hpvdt/falcon_wing_module/media/wing_control_neutral_position.png

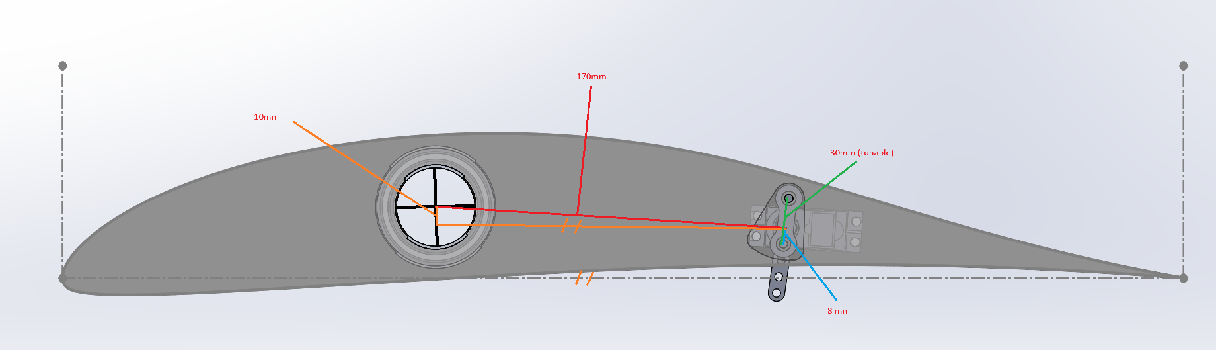
media/wing_control_neutral_position.png
