hpvdt/falcon_wing_module/media/wing_control_fully_actuated_position.png

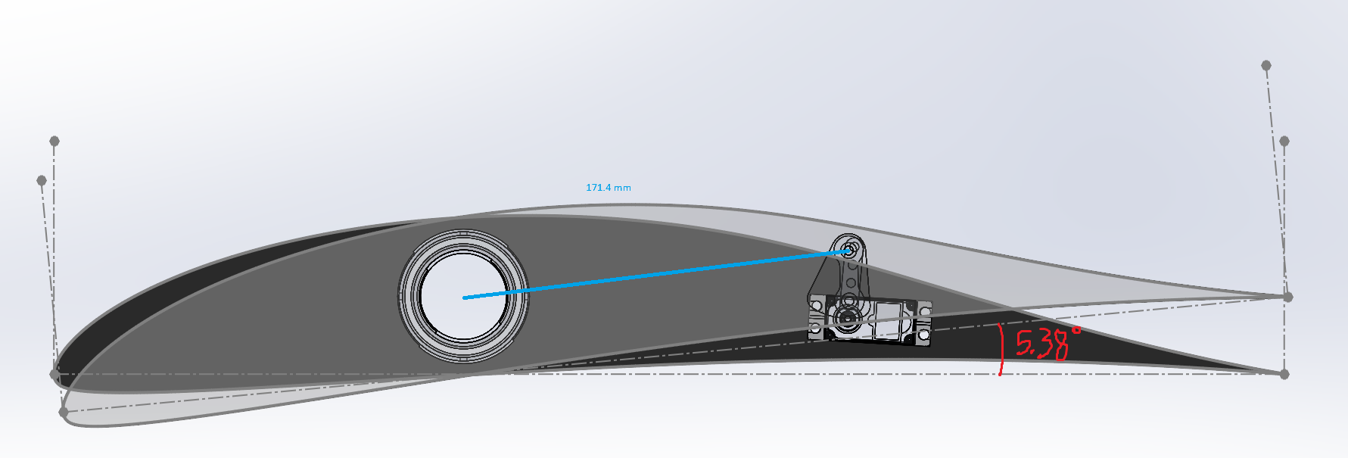
media/wing_control_fully_actuated_position.png
