hpvdt/falcon_wing_module/README.md

# falcon_wing_module
General purpose modules for handling wing duties
