hpvdt/falcon_wing_module/hardware/indicator_rev_2/TCA6408ARSVR/TCA6408ARSVR.step

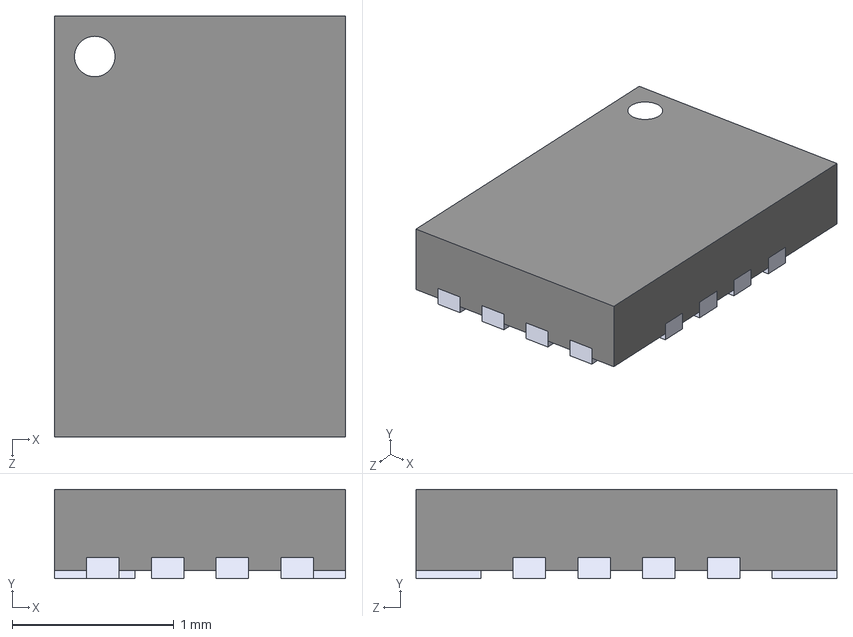
[picture p3: CAD file, 2025-09-16]
hardware/indicator_rev_2/TCA6408ARSVR/TCA6408ARSVR.step
1.80 x 0.55 x 2.60 mm
