hpvdt/falcon_wing_module/hardware/indicator_rev_2/TLV70033DCKR/TLV70033DCKR.step

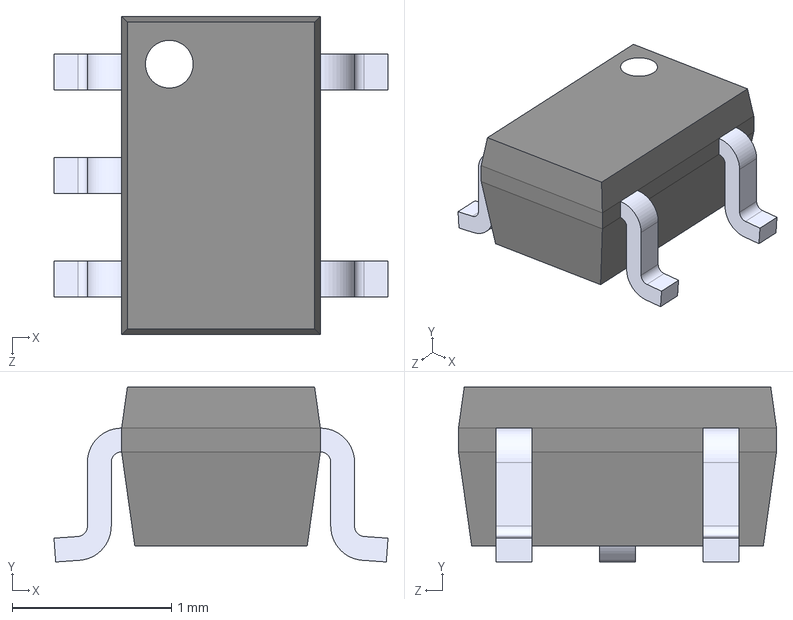
[picture p4: CAD file, 2025-09-16]
hardware/indicator_rev_2/TLV70033DCKR/TLV70033DCKR.step
2.10 x 1.10 x 2.00 mm
