hpvdt/falcon_wing_module/(threads)

Thread 2 (2025-09-02):

Add LIDAR functionality

savob, 2025-09-02:
Add functionality for the I2C LIDAR to be read and reported by these modules. We've been using [TFMini-S](https://www.sparkfun.com/tfmini-s-micro-lidar-module.html) modules, although we can change this for another option over i2C.

One thing I noticed is that UART is available over the I2C pins, although it's the same UART used for debugging so we will lose that feature if this path is taken.

Thread 3 (2025-09-02):

Add indicator board functionality

savob, 2025-09-02:
Add the needed code to operate the indicator board for the pilots. Should be a driver for the selected GPIO expander and the logic to gather and process the needed CAN frames for alerts.

Thread 4 (2025-09-03):

Control mechanism model

savob, 2025-09-03:
Nodes which are tasked with actuating control surfaces should potentially have models to describe the output angle relative to the servo angle to more accurately drive the surfaces in a way to provide the pilots a linear system.

Preliminary work has been done using the `wing_sweep.m` script to plot the system and this could be easily adapted to provide a lookup table or port the calculations directly into the modules if the math proves fast enough to run on the microcontrollers.

savob, 2025-09-03:
Some interesting approximations and calculations to consider if the math proves to be slow https://www.olliw.eu/2014/fast-functions/

Thread 5 (2025-09-06):

Issue running servo PWM and I2C

savob, 2025-09-06:
Given some unforeseen issues arising from the alternate pin function system in STM32s, the servo PWM pin (PB5) on the rev 1.0 module board cannot be properly driven when I2C is active.

The issue appears that although the SMBA pin functionality for the I2C peripheral overrides the PWM functionality on that pin, even though SMBA is not meant to be activated/used in our system. This is an issue with the design of the chip so we'll need to use modules for only one or the other function at a time.

A viable solution is to swap the pins purpose with ADD2, since the same timer has a PWM output there that is works alongside I2C, but this will need a hardware revision that is unlikely and unnecessary in the near future. We can just co-locate two modes as needed.
