hpvdt/falcon_wing_module/hardware/indicator_rev_2/indicator_rev_2.kicad_pcb

## KiCad design hardware/indicator_rev_2/indicator_rev_2.kicad_pcb (2025-09-16)

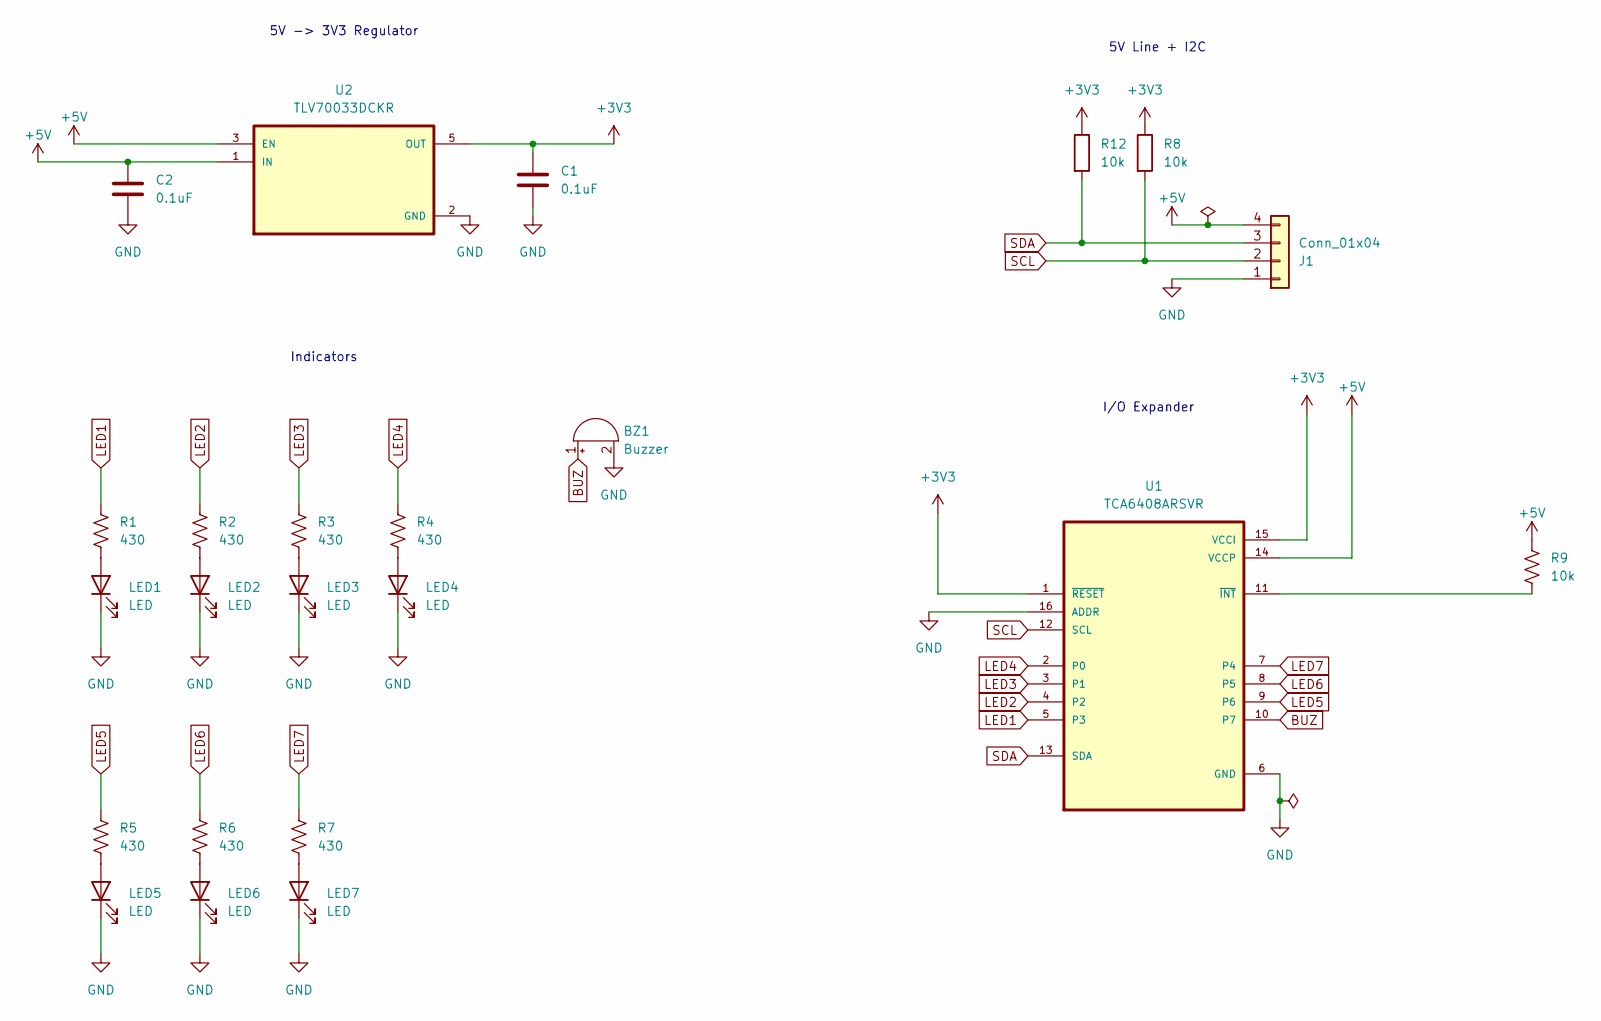
[picture p5: schematic indicator_rev_2.kicad_sch, Indicator Board]

Parts:
BZ1: Buzzer; Buzzer_12x9.5RM7.6
C1, C2: 0.1uF; C_0603_1608Metric
J1: Conn_01x04; JST_XH_S4B-XH-A_1x04_P2.50mm_Horizontal
LED1, LED2, LED3, LED4, LED5, LED6, LED7: LED; LED_D4.0mm
R1, R2, R3, R4, R5, R6, R7: 430; R_0603_1608Metric
R8, R9, R12: 10k; R_0603_1608Metric
U1: TCA6408ARSVR; QFN40P180X260X55-16N
U2: TLV70033DCKR; SOT65P210X110-5N

Connections:
+3V3: C1.1, R8.1, R12.1, U1.1 (~RESET), U1.15 (VCCI), U2.5 (OUT)
+5V: C2.1, J1.4, R9.2, U1.14 (VCCP), U2.1 (IN), U2.3 (EN)
BUZ: BZ1.1 (-), U1.10 (P7)
GND: BZ1.2 (+), C1.2, C2.2, J1.1, LED1.1 (K), LED2.1 (K), LED3.1 (K), LED4.1 (K), LED5.1 (K), LED6.1 (K), LED7.1 (K), U1.6 (GND), U1.16 (ADDR), U2.2 (GND)
LED1: R1.2, U1.5 (P3)
LED2: R2.2, U1.4 (P2)
LED3: R3.2, U1.3 (P1)
LED4: R4.2, U1.2 (P0)
LED5: R5.2, U1.9 (P6)
LED6: R6.2, U1.8 (P5)
LED7: R7.2, U1.7 (P4)
unnamed: LED1.2 (A), R1.1
unnamed: LED2.2 (A), R2.1
unnamed: LED3.2 (A), R3.1
unnamed: LED4.2 (A), R4.1
unnamed: LED5.2 (A), R5.1
unnamed: LED6.2 (A), R6.1
unnamed: LED7.2 (A), R7.1
unnamed: R9.1, U1.11 (~INT)
SCL: J1.2, R8.2, U1.12 (SCL)
SDA: J1.3, R12.2, U1.13 (SDA)

Notes on the sheet:
5V Line + I2C
I/O Expander
5V -> 3V3 Regulator
Indicators

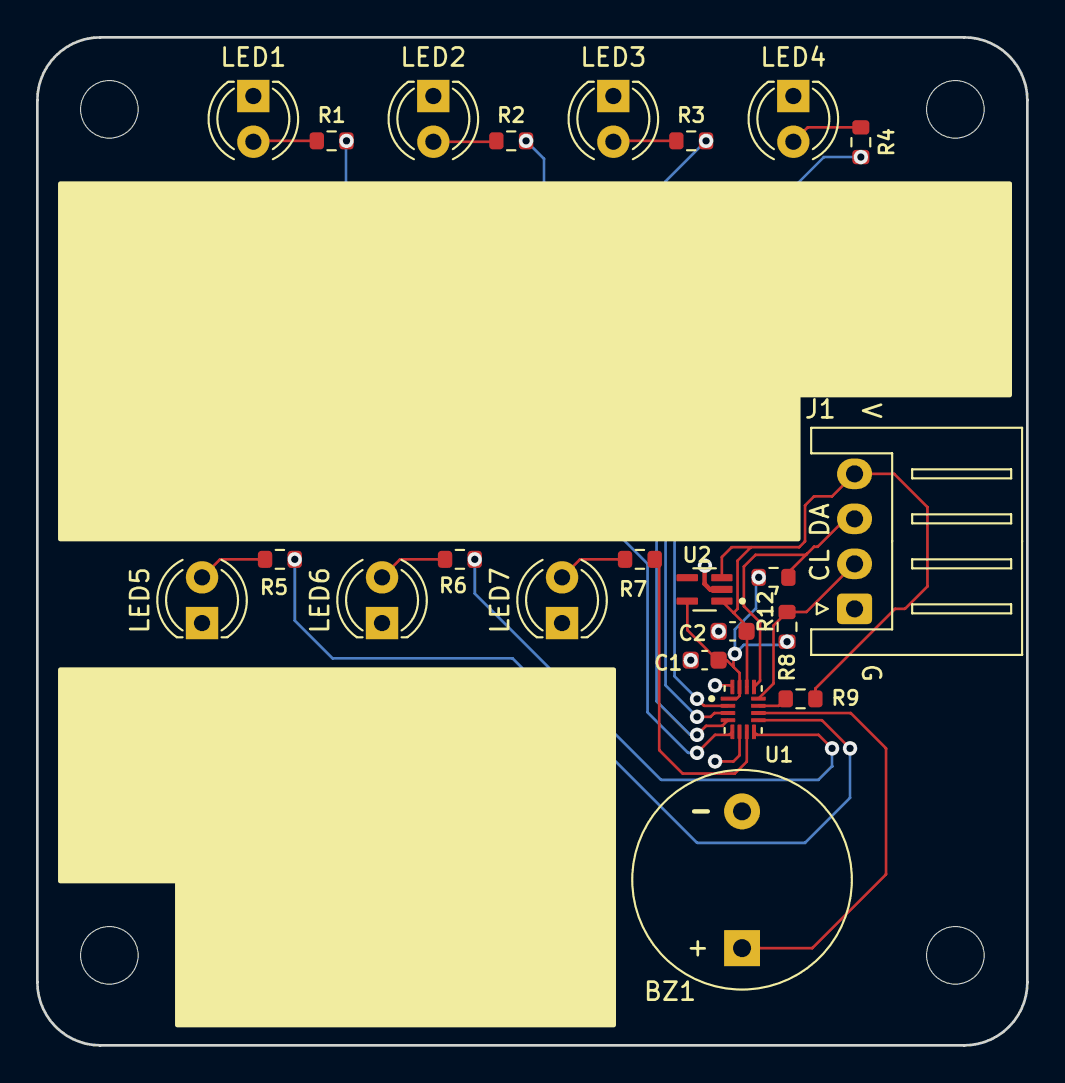
[picture p6: board indicator_rev_2.kicad_pcb from above]

Board: 2 copper layers, 55.0 x 56.0 mm, 23 parts (0 on the bottom side), 21 nets.
