hpvdt/falcon_wing_module/hardware/wing_module_rev_1/wing_module_rev_1.kicad_pcb

## KiCad design hardware/wing_module_rev_1/wing_module_rev_1.kicad_pcb (2025-08-17)

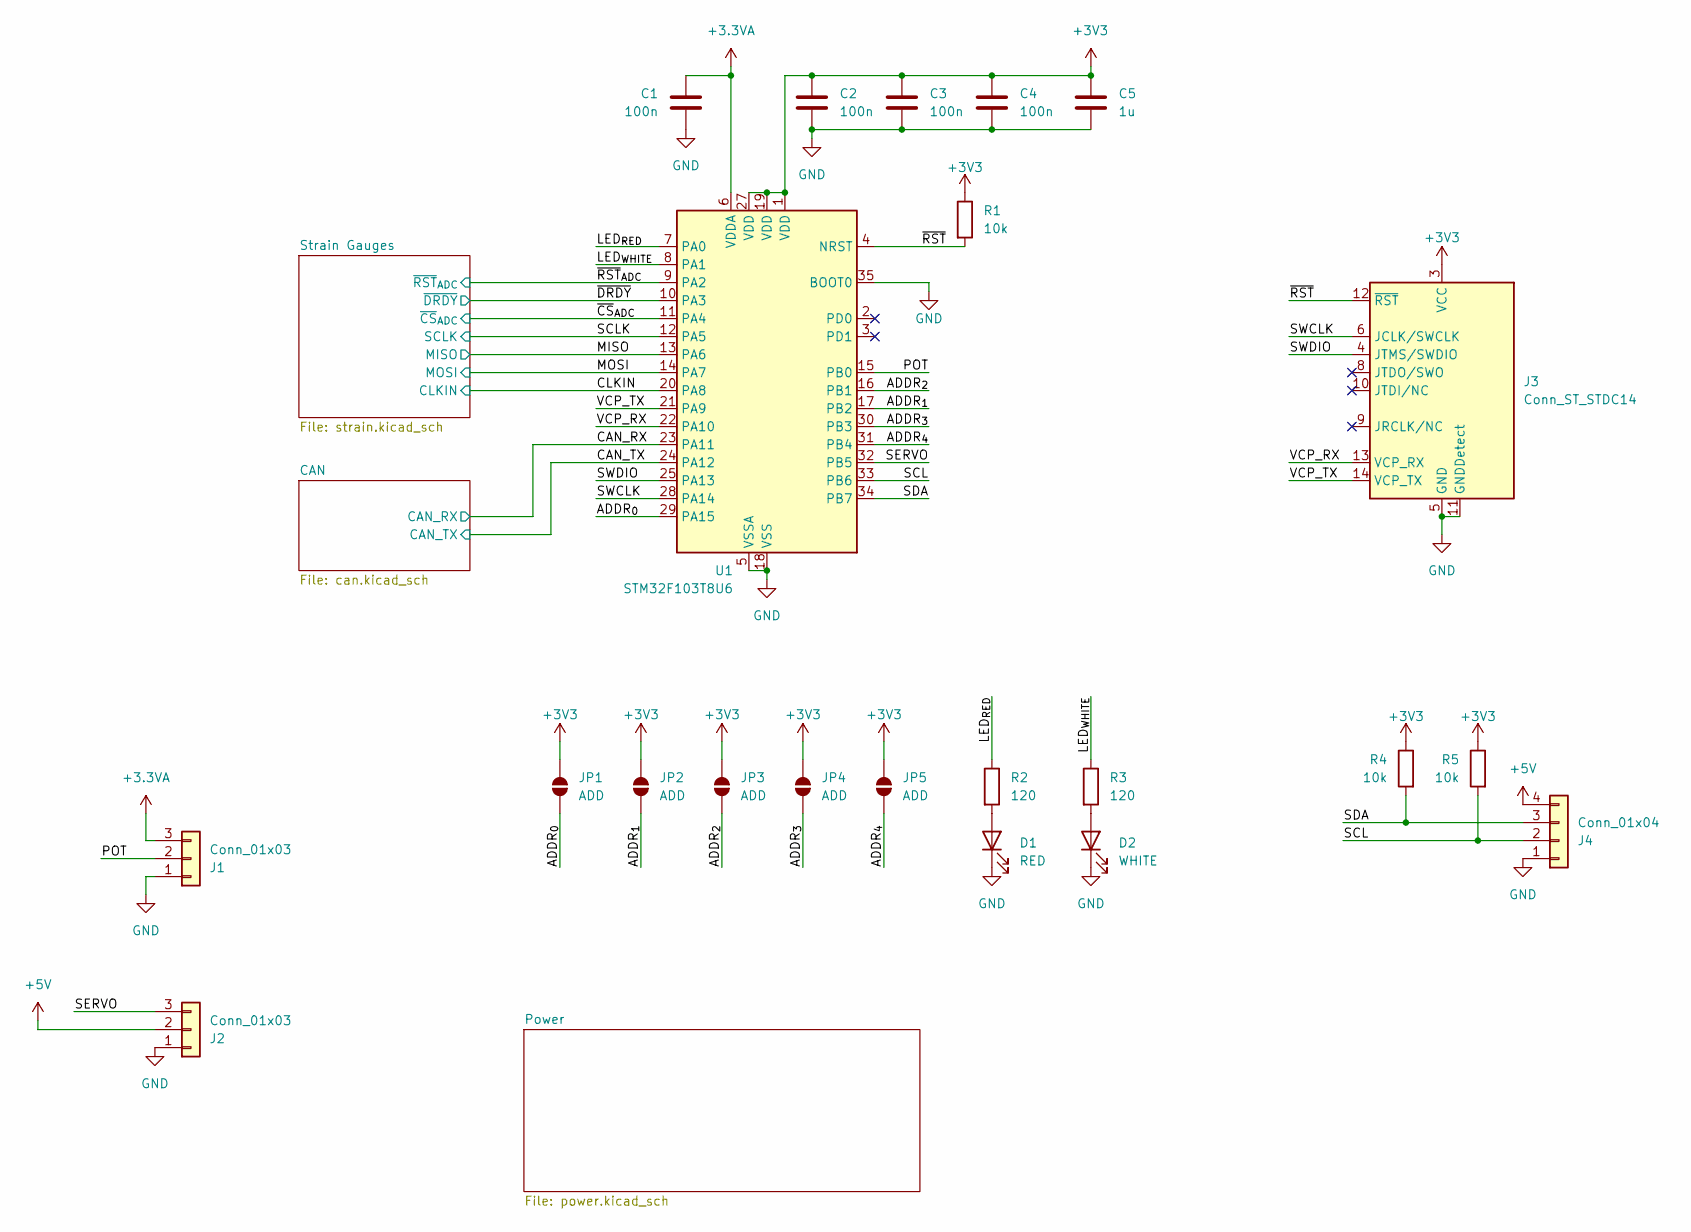
[picture p7: schematic wing_module_rev_1.kicad_sch, Wing Module]

Parts:
C1, C2, C3, C4: 100n; C_0402_1005Metric; LCSC C5448875
C5: 1u; C_0402_1005Metric; LCSC C52923
D1: RED; LED_0805_2012Metric; LCSC C84256
D2: WHITE; LED_0805_2012Metric; LCSC C34499
J1, J2: Conn_01x03; JST_EH_B3B-EH-A_1x03_P2.50mm_Vertical; LCSC C398546
J3: Conn_ST_STDC14; PinHeader_2x07_P1.27mm_Vertical_SMD; LCSC C6332251
J4: Conn_01x04; JST_EH_B4B-EH-A_1x04_P2.50mm_Vertical; LCSC C160258
JP1, JP2, JP3, JP4, JP5: ADD; SolderJumper-2_P1.3mm_Open_TrianglePad1.0x1.5mm; LCSC N/A
R1, R4, R5: 10k; R_0402_1005Metric; LCSC C723353
R2, R3: 120; R_0402_1005Metric; LCSC C25079
U1: STM32F103T8U6; QFN-36-1EP_6x6mm_P0.5mm_EP3.7x3.7mm; LCSC C19671

Connections:
+3.3VA: C1.1, J1.3, U1.6 (VDDA); also elsewhere on the board
+3V3: C2.1, C3.1, C4.1, C5.1, J3.3 (VCC), JP1.2 (B), JP2.2 (B), JP3.2 (B), JP4.2 (B), JP5.2 (B), R1.1, R4.1, R5.1, U1.1 (VDD), U1.19 (VDD), U1.27 (VDD); also elsewhere on the board
+5V: J2.2, J4.4; also elsewhere on the board
/ADDR_{0}: JP1.1 (A), U1.29 (PA15)
/ADDR_{1}: JP2.1 (A), U1.17 (PB2)
/ADDR_{2}: JP3.1 (A), U1.16 (PB1)
/ADDR_{3}: JP4.1 (A), U1.30 (PB3)
/ADDR_{4}: JP5.1 (A), U1.31 (PB4)
/CAN_RX: U1.23 (PA11); also elsewhere on the board
/CAN_TX: U1.24 (PA12); also elsewhere on the board
/CLKIN: U1.20 (PA8); also elsewhere on the board
/LED_{RED}: R2.1, U1.7 (PA0)
/LED_{WHITE}: R3.1, U1.8 (PA1)
/MISO: U1.13 (PA6); also elsewhere on the board
/MOSI: U1.14 (PA7); also elsewhere on the board
/POT: J1.2, U1.15 (PB0)
/SCL: J4.2, R5.2, U1.33 (PB6)
/SCLK: U1.12 (PA5); also elsewhere on the board
/SDA: J4.3, R4.2, U1.34 (PB7)
/SERVO: J2.3, U1.32 (PB5)
/SWCLK: J3.6 (JCLK/SWCLK), U1.28 (PA14)
/SWDIO: J3.4 (JTMS/SWDIO), U1.25 (PA13)
/VCP_RX: J3.13 (VCP_RX), U1.22 (PA10)
/VCP_TX: J3.14 (VCP_TX), U1.21 (PA9)
/~CS_{ADC}: U1.11 (PA4); also elsewhere on the board
/~DRDY: U1.10 (PA3); also elsewhere on the board
/~RST: J3.12 (~RST), R1.2, U1.4 (NRST)
/~RST_{ADC}: U1.9 (PA2); also elsewhere on the board
GND: C1.2, C2.2, C3.2, C4.2, C5.2, D1.1 (K), D2.1 (K), J1.1, J2.1, J3.5 (GND), J3.7 (GND), J3.11 (GNDDetect), J4.1, U1.5 (VSSA), U1.18 (VSS), U1.26 (VSS), U1.35 (BOOT0), U1.36 (VSS), U1.37 (VSS); also elsewhere on the board
unnamed: D1.2 (A), R2.2
unnamed: D2.2 (A), R3.2

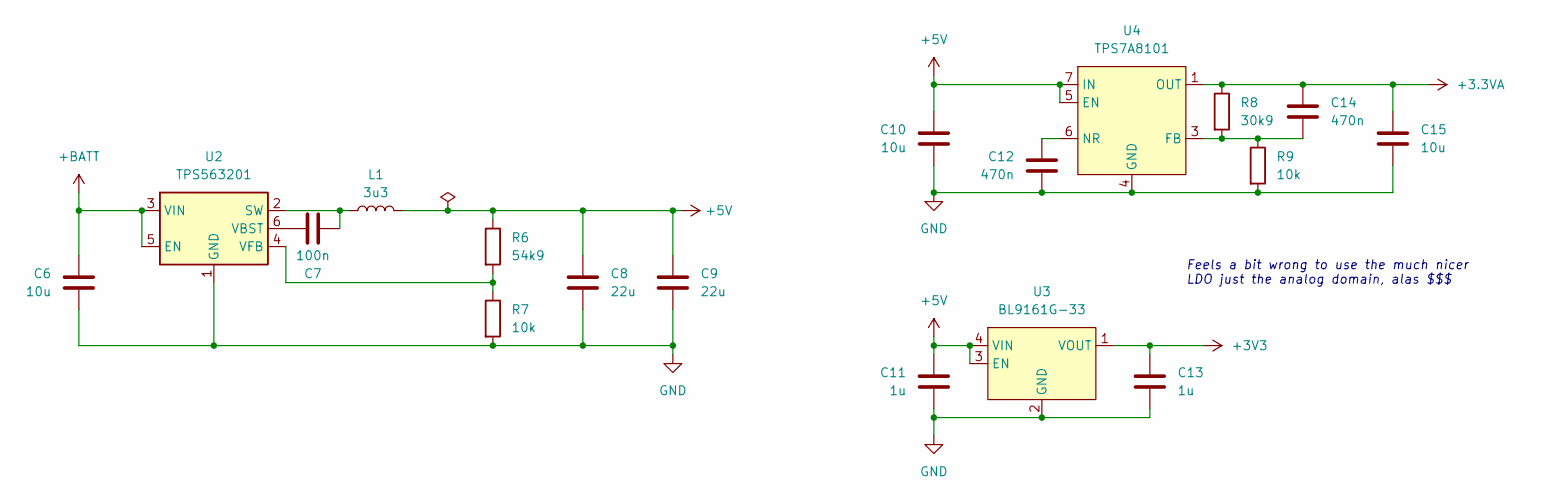
[picture p8: schematic power.kicad_sch, Power regulators]

Parts:
C6, C10, C15: 10u; C_0603_1608Metric; LCSC C5360828
C7: 100n; C_0402_1005Metric; LCSC C5448875
C8, C9: 22u; C_0603_1608Metric; LCSC C86295
C11, C13: 1u; C_0402_1005Metric; LCSC C52923
C12, C14: 470n; C_0402_1005Metric; LCSC C47339
L1: 3u3; L_Changjiang_FNR6045S; LCSC C168063
R6: 54k9; R_0402_1005Metric; LCSC C227137
R7, R9: 10k; R_0402_1005Metric; LCSC C723353
R8: 30k9; R_0402_1005Metric; LCSC C1883526
U2: TPS563201; SOT-23-6; LCSC C116592
U3: BL9161G-33; UDFN-4-1EP_1x1mm_P0.65mm_EP0.48x0.48mm; LCSC C2999146
U4: TPS7A8101; VSON-8-1EP_3x3mm_P0.65mm_EP1.65x2.4mm; LCSC C465730

Connections:
+3.3VA: C14.1, C15.1, R8.1, U4.1 (OUT), U4.2 (OUT); also elsewhere on the board
+3V3: C13.1, U3.1 (VOUT); also elsewhere on the board
+5V: C8.1, C9.1, C10.1, C11.1, L1.2, R6.1, U3.3 (EN), U3.4 (VIN), U4.5 (EN), U4.7 (IN), U4.8 (IN); also elsewhere on the board
+BATT: C6.1, U2.3 (VIN), U2.5 (EN); also elsewhere on the board
GND: C6.2, C8.2, C9.2, C10.2, C11.2, C12.2, C13.2, C15.2, R7.2, R9.2, U2.1 (GND), U3.2 (GND), U3.5 (GND), U4.4 (GND), U4.9 (GND); also elsewhere on the board
unnamed: C7.2, L1.1, U2.2 (SW)
unnamed: C7.1, U2.6 (VBST)
unnamed: R6.2, R7.1, U2.4 (VFB)
unnamed: C14.2, R8.2, R9.1, U4.3 (FB)
unnamed: C12.1, U4.6 (NR)

Notes on the sheet:
Feels a bit wrong to use the much nicer LDO just the analog domain, alas $$$

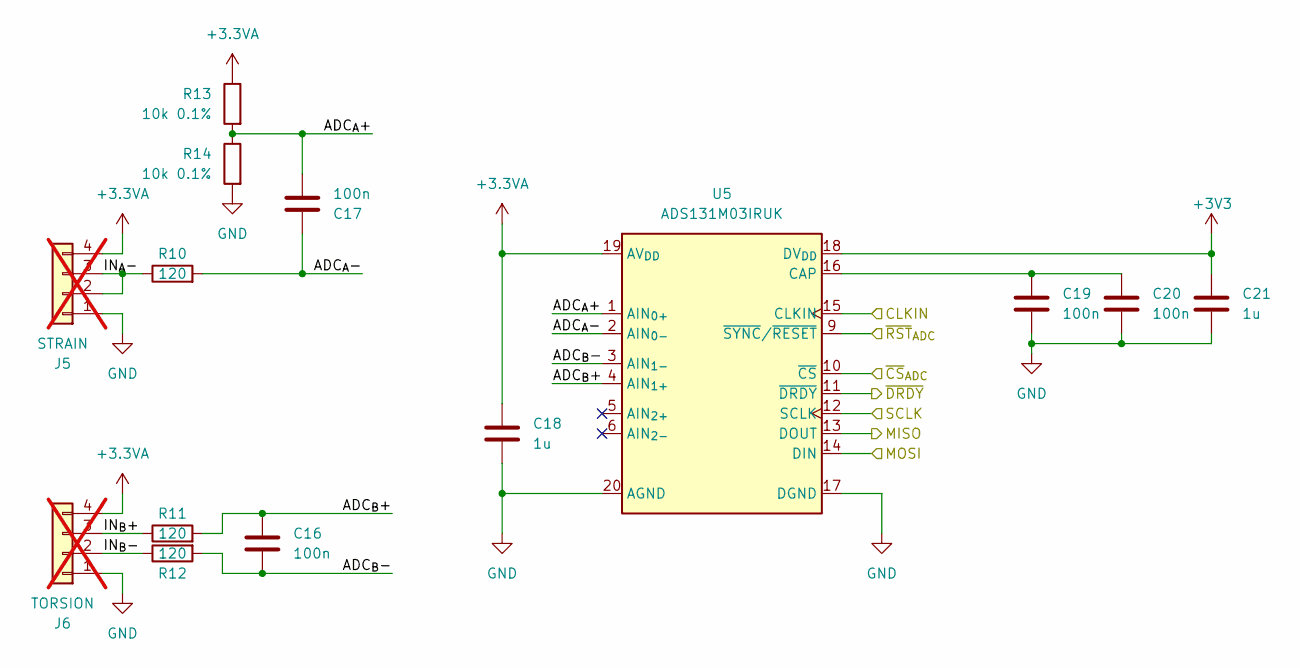
[picture p9: schematic strain.kicad_sch, Strain Gauge Measuring System]

Parts:
C16, C17, C19, C20: 100n; C_0402_1005Metric; LCSC C5448875
C18, C21: 1u; C_0402_1005Metric; LCSC C52923
J5: STRAIN; PinHeader_1x04_P2.00mm_Vertical; LCSC N/A; not fitted
J6: TORSION; PinHeader_1x04_P2.00mm_Vertical; LCSC N/A; not fitted
R10, R11, R12: 120; R_0402_1005Metric; LCSC C25079
R13, R14: 10k 0.1%; R_0402_1005Metric; LCSC C191915
U5: ADS131M03IRUK; WQFN-20-1EP_3x3mm_P0.4mm_EP1.7x1.7mm; LCSC C5116472

Connections:
+3.3VA: C18.1, J5.4, J6.4, R13.1, U5.19 (AV_{DD}); also elsewhere on the board
+3V3: C21.1, U5.18 (DV_{DD}); also elsewhere on the board
/CLKIN: U5.15 (CLKIN); also elsewhere on the board
/MISO: U5.13 (DOUT); also elsewhere on the board
/MOSI: U5.14 (DIN); also elsewhere on the board
/SCLK: U5.12 (SCLK); also elsewhere on the board
/Strain Gauges/ADC_{A}+: C17.2, R13.2, R14.1, U5.1 (AIN_{0+})
/Strain Gauges/ADC_{A}-: C17.1, R10.2, U5.2 (AIN_{0-})
/Strain Gauges/ADC_{B}+: C16.1, R11.2, U5.4 (AIN_{1+})
/Strain Gauges/ADC_{B}-: C16.2, R12.2, U5.3 (AIN_{1-})
/Strain Gauges/IN_{A}-: J5.2, J5.3, R10.1
/Strain Gauges/IN_{B}+: J6.3, R11.1
/Strain Gauges/IN_{B}-: J6.2, R12.1
/~CS_{ADC}: U5.10 (~CS); also elsewhere on the board
/~DRDY: U5.11 (~DRDY); also elsewhere on the board
/~RST_{ADC}: U5.9 (~SYNC/~RESET); also elsewhere on the board
GND: C18.2, C19.2, C20.2, C21.2, J5.1, J6.1, R14.2, U5.17 (DGND), U5.20 (AGND), U5.21 (AGND); also elsewhere on the board
unnamed: C19.1, C20.1, U5.16 (CAP)

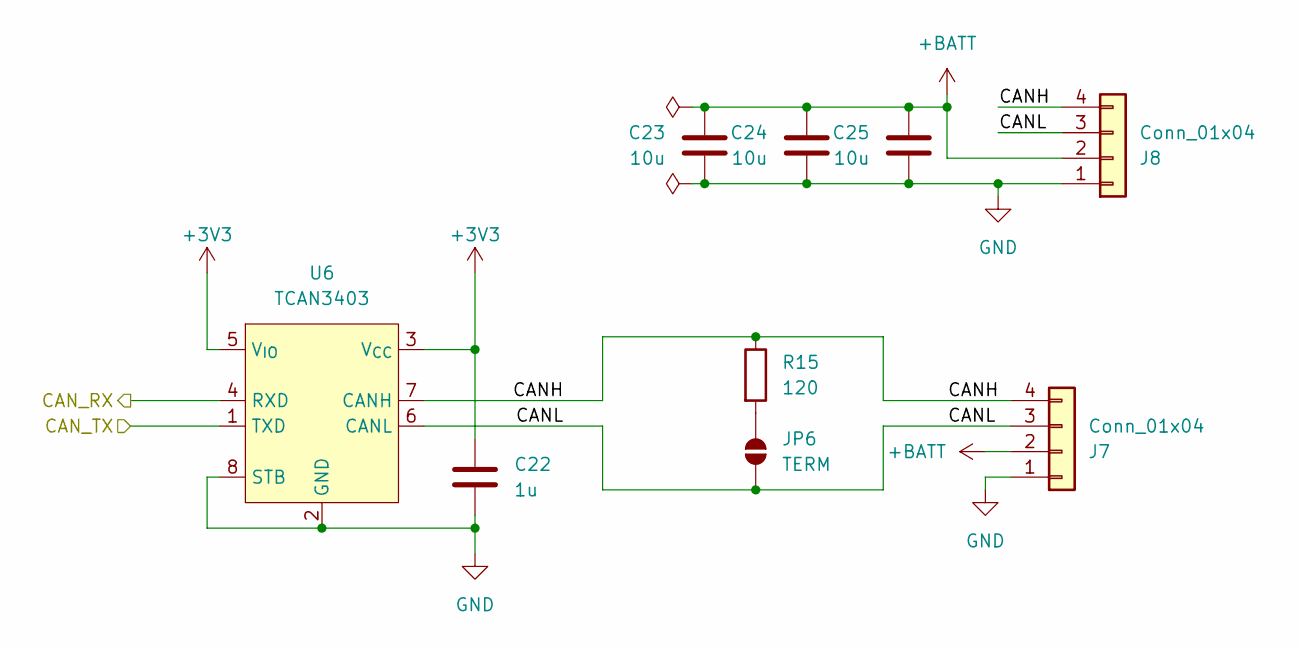
[picture p10: schematic can.kicad_sch, CAN Interface]

Parts:
C22: 1u; C_0402_1005Metric; LCSC C52923
C23, C24, C25: 10u; C_0603_1608Metric; LCSC C5360828
J7, J8: Conn_01x04; JST_EH_B4B-EH-A_1x04_P2.50mm_Vertical; LCSC C160258
JP6: TERM; SolderJumper-2_P1.3mm_Open_TrianglePad1.0x1.5mm; LCSC N/A
R15: 120; R_0402_1005Metric; LCSC C25079
U6: TCAN3403; TSOT-23-8; LCSC C35926232

Connections:
+3V3: C22.1, U6.3 (V_{CC}), U6.5 (V_{IO}); also elsewhere on the board
+BATT: C23.1, C24.1, C25.1, J7.2, J8.2; also elsewhere on the board
/CAN/CANH: J7.4, J8.4, R15.1, U6.7 (CANH)
/CAN/CANL: J7.3, J8.3, JP6.2 (B), U6.6 (CANL)
/CAN_RX: U6.4 (RXD); also elsewhere on the board
/CAN_TX: U6.1 (TXD); also elsewhere on the board
GND: C22.2, C23.2, C24.2, C25.2, J7.1, J8.1, U6.2 (GND), U6.8 (STB); also elsewhere on the board
unnamed: JP6.1 (A), R15.2

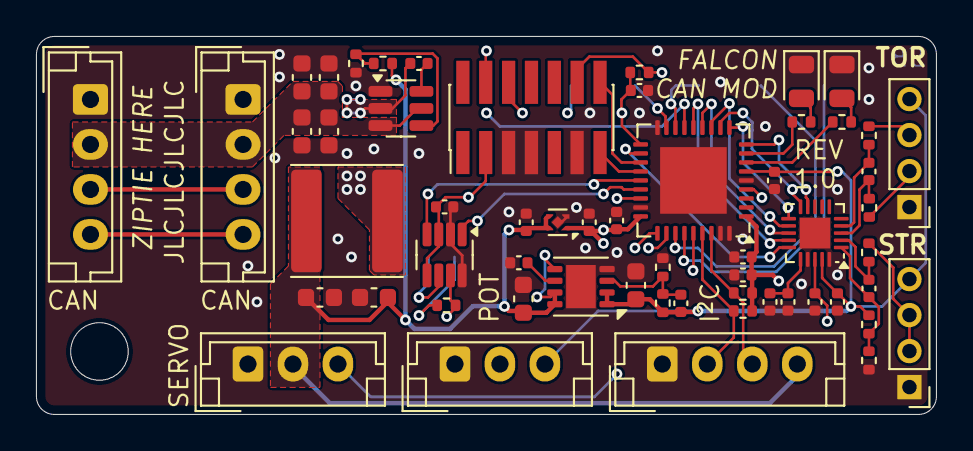
[picture p11: board wing_module_rev_1.kicad_pcb from above]

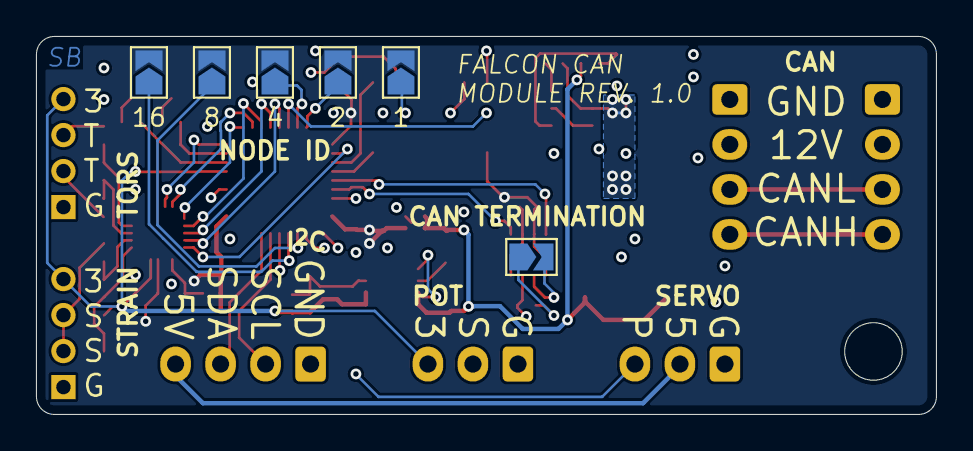
[picture p12: board wing_module_rev_1.kicad_pcb from below]

Board: 4 copper layers, 50.0 x 21.0 mm, 63 parts (6 on the bottom side), 48 nets.
