hpvdt/falcon_wing_module/hardware/servo_regulator/servo_regulator.kicad_pcb

## KiCad design hardware/servo_regulator/servo_regulator.kicad_pcb (2025-08-09)

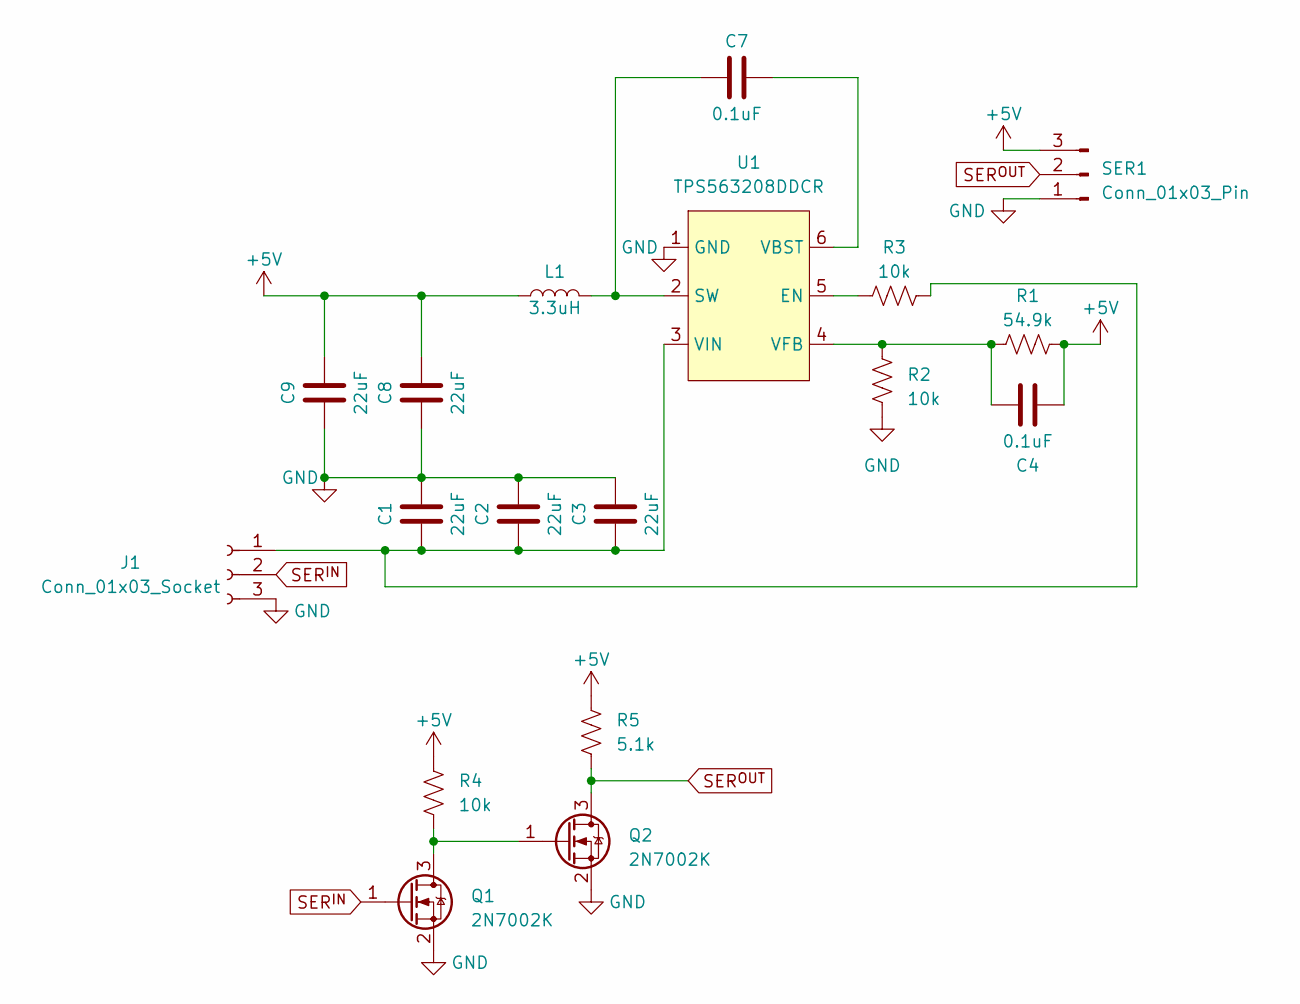
[picture p13: schematic servo_regulator.kicad_sch, Aircraft Joystick Reader & Regulator - Servo]

Parts:
C1, C2, C3, C8, C9: 22uF; C_0805_2012Metric
C4, C7: 0.1uF; C_0805_2012Metric
J1: Conn_01x03_Socket; JST_EH_B3B-EH-A_1x03_P2.50mm_Vertical
L1: 3.3uH; L_Taiyo-Yuden_NR-60xx
Q1, Q2: 2N7002K; SOT-23
R1: 54.9k; R_0603_1608Metric
R2, R3, R4: 10k; R_0603_1608Metric
R5: 5.1k; R_0603_1608Metric
SER1: Conn_01x03_Pin; JST_EH_B3B-EH-A_1x03_P2.50mm_Vertical
U1: TPS563208DDCR; TSOT-23-6

Connections:
+5V: C4.2, C8.2, C9.2, L1.1, R1.1, R4.1, R5.1, SER1.3
GND: C1.2, C2.2, C3.2, C8.1, C9.1, J1.3, Q1.2 (S), Q2.2 (S), R2.1, SER1.1, U1.1 (GND)
unnamed: C1.1, C2.1, C3.1, J1.1, R3.2, U1.3 (VIN)
unnamed: Q1.3 (D), Q2.1 (G), R4.2
unnamed: R3.1, U1.5 (EN)
unnamed: C7.1, L1.2, U1.2 (SW)
unnamed: C7.2, U1.6 (VBST)
unnamed: C4.1, R1.2, R2.2, U1.4 (VFB)
SER^{IN}: J1.2, Q1.1 (G)
SER^{OUT}: Q2.3 (D), R5.2, SER1.2

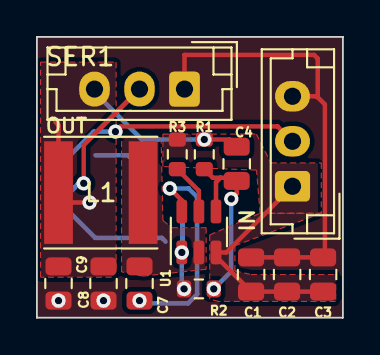
[picture p14: board servo_regulator.kicad_pcb from above]

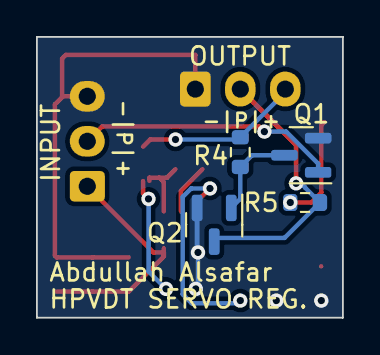
[picture p15: board servo_regulator.kicad_pcb from below]

Board: 2 copper layers, 17.0 x 15.6 mm, 18 parts (4 on the bottom side), 10 nets.
