hpvdt/falcon_wing_module/hardware/spar_sensor/spar_sensor.kicad_pcb

## KiCad design hardware/spar_sensor/spar_sensor.kicad_pcb (2025-08-09)

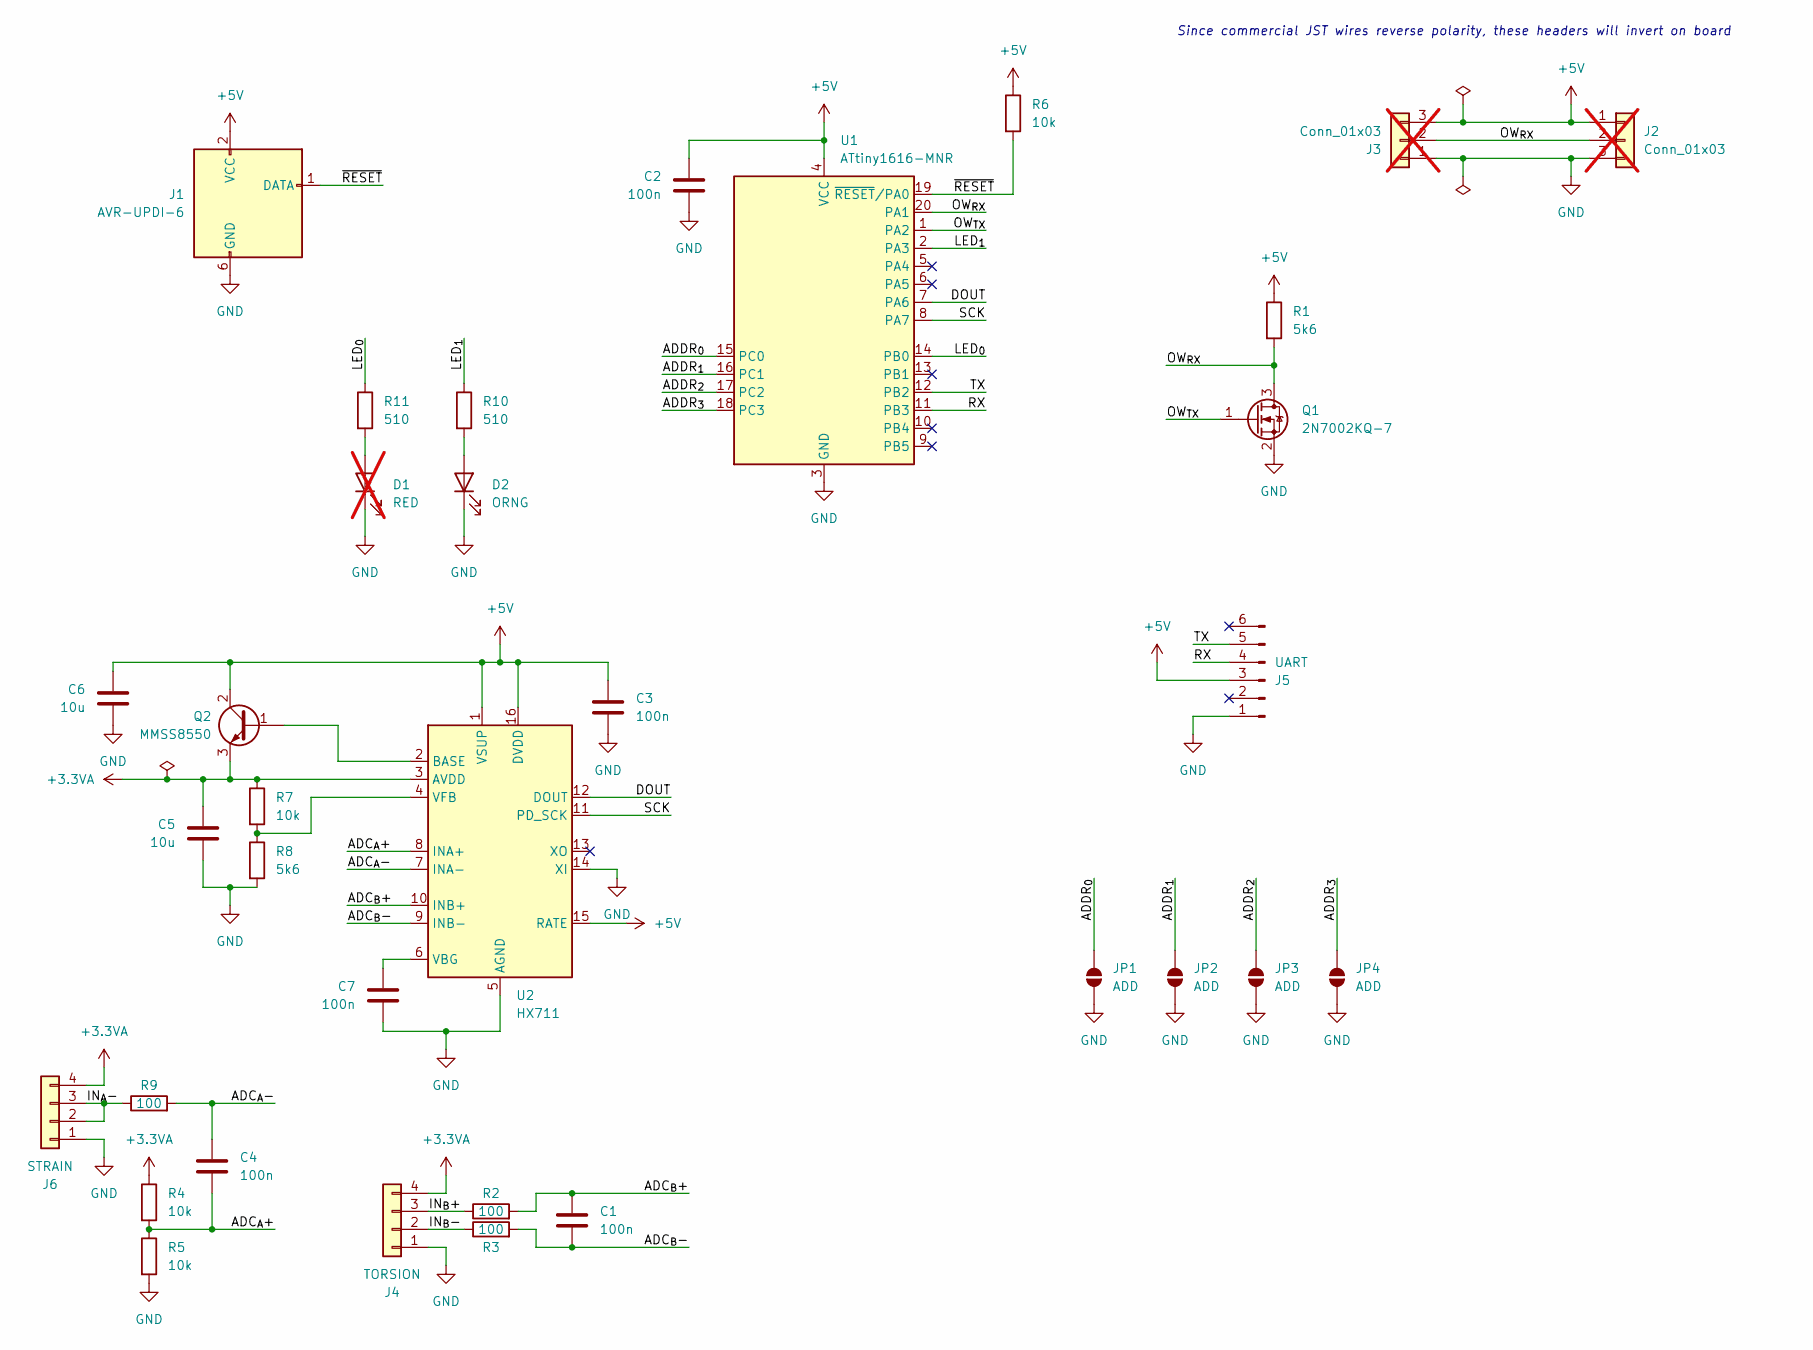
[picture p16: schematic spar_sensor.kicad_sch, Distributed Spar Load Sensors System]

Parts:
C1, C2, C3, C4, C7: 100n; C_0402_1005Metric; LCSC C5448875
C5, C6: 10u; C_0603_1608Metric; LCSC C5360828
D1: RED; LED_0805_2012Metric; LCSC N/A; not fitted
D2: ORNG; LED_0805_2012Metric; LCSC C2292
J1: AVR-UPDI-6; Tag-Connect_TC2030-IDC-NL_2x03_P1.27mm_Vertical; LCSC N/A
J2, J3: Conn_01x03; JST_EH_B3B-EH-A_1x03_P2.50mm_Vertical; LCSC C398546; not fitted
J4: TORSION; PinHeader_1x04_P2.00mm_Vertical; LCSC N/A
J5: UART; PinHeader_1x06_P2.54mm_Vertical; LCSC N/A
J6: STRAIN; PinHeader_1x04_P2.00mm_Vertical; LCSC N/A
JP1, JP2, JP3, JP4: ADD; SolderJumper-2_P1.3mm_Open_TrianglePad1.0x1.5mm; LCSC N/A
Q1: 2N7002KQ-7; SOT-23; LCSC C111971
Q2: MMSS8550; SOT-23; LCSC C192429
R1, R8: 5k6; R_0402_1005Metric; LCSC C340537
R2, R3, R9: 100; R_0402_1005Metric; LCSC C606168
R4, R5: 10k; R_0402_1005Metric; LCSC C191915
R6, R7: 10k; R_0402_1005Metric; LCSC C723353
R10, R11: 510; R_0402_1005Metric; LCSC C2991609
U1: ATtiny1616-MNR; VQFN-20-1EP_3x3mm_P0.4mm_EP1.7x1.7mm; LCSC C507118
U2: HX711; SOP-16_3.9x9.9mm_P1.27mm; LCSC C6705483

Connections:
+3.3VA: C5.1, J4.4, J6.4, Q2.3 (E), R4.1, R7.1, U2.3 (AVDD)
+5V: C2.1, C3.1, C6.1, J1.2 (VCC), J2.1, J3.3, J5.3, Q2.2 (C), R1.1, R6.1, U1.4 (VCC), U2.1 (VSUP), U2.15 (RATE), U2.16 (DVDD)
/ADC_{A}+: C4.2, R4.2, R5.1, U2.8 (INA+)
/ADC_{A}-: C4.1, R9.2, U2.7 (INA-)
/ADC_{B}+: C1.1, R2.2, U2.10 (INB+)
/ADC_{B}-: C1.2, R3.2, U2.9 (INB-)
/ADDR_{0}: JP1.2 (B), U1.15 (PC0)
/ADDR_{1}: JP2.2 (B), U1.16 (PC1)
/ADDR_{2}: JP3.2 (B), U1.17 (PC2)
/ADDR_{3}: JP4.2 (B), U1.18 (PC3)
/DOUT: U1.7 (PA6), U2.12 (DOUT)
/IN_{A}-: J6.2, J6.3, R9.1
/IN_{B}+: J4.3, R2.1
/IN_{B}-: J4.2, R3.1
/LED_{0}: R11.1, U1.14 (PB0)
/LED_{1}: R10.1, U1.2 (PA3)
/OW_{RX}: J2.2, J3.2, Q1.3 (D), R1.2, U1.20 (PA1)
/OW_{TX}: Q1.1 (G), U1.1 (PA2)
/RX: J5.4, U1.11 (PB3)
/SCK: U1.8 (PA7), U2.11 (PD_SCK)
/TX: J5.5, U1.12 (PB2)
/~RESET: J1.1 (DATA), R6.2, U1.19 (~RESET/PA0)
GND: C2.2, C3.2, C5.2, C6.2, C7.2, D1.1 (K), D2.1 (K), J1.6 (GND), J2.3, J3.1, J4.1, J5.1, J6.1, JP1.1 (A), JP2.1 (A), JP3.1 (A), JP4.1 (A), Q1.2 (S), R5.2, R8.2, U1.3 (GND), U1.21 (GND), U2.5 (AGND), U2.14 (XI)
unnamed: D1.2 (A), R11.2
unnamed: D2.2 (A), R10.2
unnamed: Q2.1 (B), U2.2 (BASE)
unnamed: C7.1, U2.6 (VBG)
unnamed: R7.2, R8.1, U2.4 (VFB)

Notes on the sheet:
Since commercial JST wires reverse polarity, these headers will invert on board

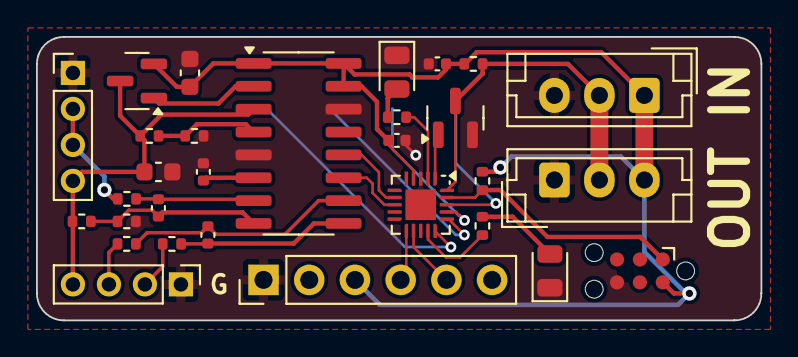
[picture p17: board spar_sensor.kicad_pcb from above]

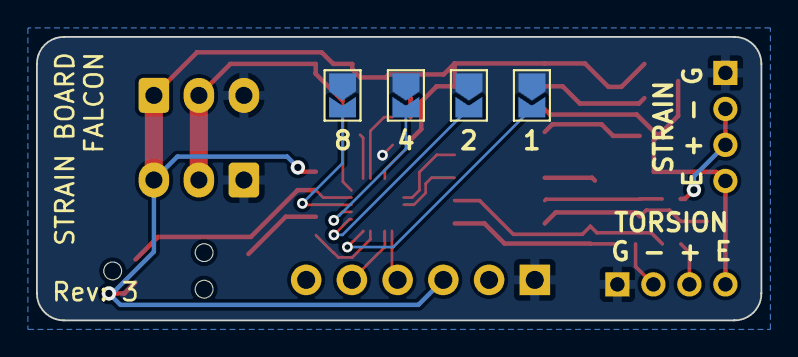
[picture p18: board spar_sensor.kicad_pcb from below]

Board: 2 copper layers, 40.2 x 15.8 mm, 34 parts (4 on the bottom side), 28 nets.
