hpvdt/falcon_wing_module/firmware/wing_module/Core/Src/main.c

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
/* Includes ------------------------------------------------------------------*/
#include "main.h"

/* USER CODE BEGIN Includes */
#include "wing_module_config.h"
#include "can_wrapper.h"
#include <stdint.h>
#include <stdio.h>
#include <string.h>
#include "ads131m03.h"
#include "led_control.h"
#include "surface_control.h"
/* USER CODE END Includes */

ADC_HandleTypeDef hadc1;

CAN_HandleTypeDef hcan;

SPI_HandleTypeDef hspi1;

TIM_HandleTypeDef htim2;
TIM_HandleTypeDef htim3;

UART_HandleTypeDef huart1;

/* USER CODE BEGIN PV */
struct WingModuleConfig config;
/* USER CODE END PV */

void SystemClock_Config(void);
static void MX_GPIO_Init(void);
static void MX_CAN_Init(void);
static void MX_SPI1_Init(void);
static void MX_TIM2_Init(void);
static void MX_USART1_UART_Init(void);
static void MX_ADC1_Init(void);
static void MX_TIM3_Init(void);
/* USER CODE BEGIN PFP */
#ifdef __GNUC__
/* With GCC/RAISONANCE, small printf (option LD Linker->Libraries->Small printf
   set to 'Yes') calls __io_putchar() */
#define PUTCHAR_PROTOTYPE int __io_putchar(int ch)
#else
#define PUTCHAR_PROTOTYPE int fputc(int ch, FILE *f)
#endif /* __GNUC__ */
/* USER CODE END PFP */

/* USER CODE BEGIN 0 */

// Since we have two FIFOs, I'll use one for configuration messages and the other for commands to the module
void can_process_config_message(struct WingModuleConfig* config, CAN_HandleTypeDef* can) {
	int messages = HAL_CAN_GetRxFifoFillLevel(can, CAN_CONFIG_FIFO);

	for (int i = 0; i < messages; i++) {
		CAN_RxHeaderTypeDef header;
		uint8_t buffer[8];
		HAL_CAN_GetRxMessage(can, CAN_CONFIG_FIFO, &header, buffer);

		unsigned int config_type = (header.StdId >> CAN_CONFIG_BIT_START) & 0x7;

		uint8_t reference_buffer[8];
		size_t length_to_consider = 0;

		switch (config_type) {
		case CONFIG_MESSAGE_GENERAL:
			length_to_consider = can_pack_node_general_config_command(reference_buffer, config->general);
			break;
		case CONFIG_MESSAGE_SERVO:
			length_to_consider = can_pack_servo_config_command(reference_buffer, config->servo);
			break;
		case CONFIG_MESSAGE_TORSION:
			length_to_consider = can_pack_strain_gauge_config_command(reference_buffer, config->torsion);
			break;
		case CONFIG_MESSAGE_STRAIN:
			length_to_consider = can_pack_strain_gauge_config_command(reference_buffer, config->strain);
			break;
		case CONFIG_MESSAGE_INDICATOR:
			length_to_consider = can_pack_indicator_config_command(reference_buffer, config->indicator);
			break;
		case CONFIG_MESSAGE_LIDAR:
			length_to_consider = can_pack_lidar_config_command(reference_buffer, config->lidar);
			break;
		default:
			continue; // Ignore unrecognized messages
		}

		bool matches_old = memcmp(reference_buffer, buffer, length_to_consider) == 0;
		bool need_this_config = (config->configuration_needed & (1 << config_type)) != 0;
		if (matches_old && !need_this_config) continue; // Skip updates if unnecessary repetition

		// Mask out the received configuration
		config->configuration_needed &= ~(1 << config_type);

		// Need to update CAN filters if the configuration changes
		switch (config_type) {
		case CONFIG_MESSAGE_GENERAL:
			can_unpack_node_general_config_command(buffer, &config->general);

			// Reset configuration
			config->configuration_needed = 0;
			if (config->general.driving_servo) 			config->configuration_needed |= 1 << CONFIG_MESSAGE_SERVO;
			if (config->general.measuring_torsion) 		config->configuration_needed |= 1 << CONFIG_MESSAGE_TORSION;
			if (config->general.measuring_strain) 		config->configuration_needed |= 1 << CONFIG_MESSAGE_STRAIN;
			if (config->general.operating_indicator) 	config->configuration_needed |= 1 << CONFIG_MESSAGE_INDICATOR;
			if (config->general.measuring_lidar) 		config->configuration_needed |= 1 << CONFIG_MESSAGE_LIDAR;
			surface_stop(); // Stop driving surface

			break;
		case CONFIG_MESSAGE_SERVO:
			can_unpack_servo_config_command(buffer, &config->servo);

			struct SurfaceConfiguration servo_config = {
				.misalignment_alarm_sec = config->servo.misalignment_alarm_sec,
				.position_tolerance = config->servo.position_tolerance_half_percent * 0.005,

				.pot_adc = &hadc1,
				.potentiometer_bottom = config->servo.potentiometer_bottom,
				.potentiometer_top = config->servo.potentiometer_top,

				.scheme = config->servo.scheme,

				.servo_bottom_us = config->servo.servo_bottom_us,
				.servo_top_us = config->servo.servo_top_us,
				.servo_timer = &htim3,
				.servo_timer_channel = TIM_CHANNEL_2,
			};

			surface_start(servo_config);
			break;
		case CONFIG_MESSAGE_TORSION:
			can_unpack_strain_gauge_config_command(buffer, &config->torsion);

			struct ADSChannelProcessingConfig temp_torsion = {
				.buffer_length = 64 * (config->torsion.buffer_depth_64_samples + 1),
				.gain = config->torsion.gain,
				.osr = config->torsion.osr,
				.zero_point = config->torsion.zero_point,
				.scaling_factor = config->torsion.scaling_factor,
			};

			ads_configure_channel(ADS_CHANNEL_TORSION, temp_torsion);
			break;
		case CONFIG_MESSAGE_STRAIN:
			can_unpack_strain_gauge_config_command(buffer, &config->strain);

			struct ADSChannelProcessingConfig temp_strain = {
				.buffer_length = 64 * (config->strain.buffer_depth_64_samples + 1),
				.gain = config->strain.gain,
				.osr = config->strain.osr,
				.zero_point = config->strain.zero_point,
				.scaling_factor = config->strain.scaling_factor,
			};

			ads_configure_channel(ADS_CHANNEL_STRAIN, temp_strain);
			break;
		case CONFIG_MESSAGE_INDICATOR:
			can_unpack_indicator_config_command(buffer, &config->indicator);
			break;
		case CONFIG_MESSAGE_LIDAR:
			can_unpack_lidar_config_command(buffer, &config->lidar);
			break;
		}
	}

	if (config->configuration_needed == 0) {
		can_update_node_filters(config, can);
	}
}

void can_process_control_message(struct WingModuleConfig* config, CAN_HandleTypeDef* can) {

}
/* USER CODE END 0 */

/**
  * @brief  The application entry point.
  * @retval int
  */
int main(void)
{

  /* MCU Configuration--------------------------------------------------------*/

  /* Reset of all peripherals, Initializes the Flash interface and the Systick. */
  HAL_Init();

  /* Configure the system clock */
  SystemClock_Config();

  /* Initialize all configured peripherals */
  MX_GPIO_Init();
  MX_CAN_Init();
  MX_SPI1_Init();
  MX_TIM2_Init();
  MX_USART1_UART_Init();
  MX_ADC1_Init();
  MX_TIM3_Init();
  /* USER CODE BEGIN 2 */

   	// NOTE: for some reason starting I2C causes issues on the channel 2 of timer 3, so it may need to be disabled for servo destined modules

	config.node_id = 0;
	const bool ADDRESS_ACTIVE = true;
	if (HAL_GPIO_ReadPin(ADDR_0_GPIO_Port, ADDR_0_Pin) == ADDRESS_ACTIVE) config.node_id += 1;
	if (HAL_GPIO_ReadPin(ADDR_1_GPIO_Port, ADDR_1_Pin) == ADDRESS_ACTIVE) config.node_id += 2;
	if (HAL_GPIO_ReadPin(ADDR_2_GPIO_Port, ADDR_2_Pin) == ADDRESS_ACTIVE) config.node_id += 4;
	if (HAL_GPIO_ReadPin(ADDR_3_GPIO_Port, ADDR_3_Pin) == ADDRESS_ACTIVE) config.node_id += 8;
	if (HAL_GPIO_ReadPin(ADDR_4_GPIO_Port, ADDR_4_Pin) == ADDRESS_ACTIVE) config.node_id += 16;
	printf("Recorded node ID as %d\r\n", config.node_id);

	config.configuration_needed = (1 << CONFIG_MESSAGE_GENERAL); // Mark need for main configuration
	// Perhaps in the future we can read in previous configuration from flash here

	can_update_node_filters(&config, &hcan);

	struct ADSConfig ads_config = {
		.bus = &hspi1,
		.cs_pin = ADS_CS_Pin,
		.cs_port = ADS_CS_GPIO_Port,
		.reset_pin = ADS_RESET_Pin,
		.reset_port = ADS_RESET_GPIO_Port,
		.data_ready_pin = ADS_DATA_RDY_Pin,
		.data_ready_port = ADS_DATA_RDY_GPIO_Port,
	};
	ads_begin(ads_config);

	struct LEDControl led = {
		.error_light_on = config.configuration_needed != 0,
		.heart_beat_max_duty = UINT8_MAX,
		.heart_beat_min_duty = 0,
		.new_pulse_data = true,
		.pulse_count = 3, // Run some flashes to start
		.pulse_period_on_ms = 1000,
		.pulse_period_off_ms = 300,

		.error_timer = &htim2,
		.error_channel = LED_RED_CHANNEL,
		.status_timer = &htim2,
		.status_channel = LED_WHITE_CHANNEL,
	};


	struct SurfaceConfiguration servo_config = {
		.misalignment_alarm_sec = 5,
		.position_tolerance = 0.1,

		.pot_adc = &hadc1,
		.potentiometer_bottom = 0,
		.potentiometer_top = 4095,

		.scheme = CONTROL_SCHEME_OPEN,

		.servo_bottom_us = 1500,
		.servo_top_us = 2500,
		.servo_timer = &htim3,
		.servo_timer_channel = SERVO_CHANNEL,
	};

	surface_start(servo_config);
  /* USER CODE END 2 */

  /* Infinite loop */
  /* USER CODE BEGIN WHILE */
	while (1) {
		const uint32_t CURRENT_TICK = HAL_GetTick();

		ads_update_channels();
		surface_control_loop();

		static uint32_t tick_mark_broadcast_ms = 0;
		if (CURRENT_TICK > tick_mark_broadcast_ms) {
			tick_mark_broadcast_ms = CURRENT_TICK + config.general.update_period_ms;
			uint8_t tx_buffer[8];

			if (config.general.measuring_strain || config.general.measuring_torsion) {
				struct CANLoadBroadcast msg = {
					.strain_reading = 0,
					.torsion_reading = 0,
				};
				if (config.general.measuring_strain) msg.strain_reading = ads_read_channel(ADS_CHANNEL_STRAIN);
				if (config.general.measuring_torsion) msg.torsion_reading = ads_read_channel(ADS_CHANNEL_TORSION);
				can_pack_load_broadcast(tx_buffer, msg);

				printf("T: %.3f\tS: %.3f\r\n", msg.torsion_reading, msg.strain_reading);

				CAN_TxHeaderTypeDef strain_gauge_header = {
					.StdId = CAN_BROADCAST_LOAD_ID_BASE | config.node_id,
					.DLC = sizeof(struct CANLoadBroadcast),
					.ExtId = 0,
					.IDE = CAN_ID_STD,
					.RTR = CAN_RTR_DATA,
					.TransmitGlobalTime = DISABLE,
				};
				uint32_t mailbox;
				if (HAL_CAN_AddTxMessage(&hcan, &strain_gauge_header, tx_buffer, &mailbox) == HAL_OK) {
					printf("SENT STRAIN READINGS OVER CAN\r\n");
				}
			}

			if (config.general.driving_servo) {
				struct CANSurfaceBroadcast msg = {
					.reading_thousandths = 0,
					.surface_not_following = false,
				};
				surface_prepare_broadcast(&msg);
				can_pack_surface_broadcast(tx_buffer, msg);

				printf("Angle: %.3f\tAlarm: %d\r\n", msg.reading_thousandths / 1000.0, msg.surface_not_following);

				CAN_TxHeaderTypeDef angle_header = {
					.StdId = CAN_BROADCAST_ANGLE_ID | config.servo.surface,
					.DLC = sizeof(struct CANSurfaceBroadcast),
					.ExtId = 0,
					.IDE = CAN_ID_STD,
					.RTR = CAN_RTR_DATA,
					.TransmitGlobalTime = DISABLE,
				};
				uint32_t mailbox;
				if (HAL_CAN_AddTxMessage(&hcan, &angle_header, tx_buffer, &mailbox) == HAL_OK) {
					printf("SENT ANGLE OVER CAN\r\n");
				}
			}
		}

		while (HAL_CAN_GetRxFifoFillLevel(&hcan, CAN_CONFIG_FIFO) > 0) {
			can_process_config_message(&config, &hcan);
		}

		while (HAL_CAN_GetRxFifoFillLevel(&hcan, CAN_COMMAND_FIFO) > 0) {
			uint8_t command_buffer[8];
			CAN_RxHeaderTypeDef command_header;

			HAL_CAN_GetRxMessage(&hcan, CAN_COMMAND_FIFO, &command_header, command_buffer);
			printf("Received command via filter %ld\r\n", command_header.FilterMatchIndex);

			switch (command_header.FilterMatchIndex) {
			case CAN_COMMAND_LIGHT_FILTER_NUMBER:
				struct CANLightCommand light_command = {0};
				can_unpack_light_command(command_buffer, &light_command);

				led.pulse_count = light_command.pulse_count;
				led.pulse_period_off_ms = light_command.pulse_period_off_ms;
				led.pulse_period_on_ms = light_command.pulse_period_on_ms;
				led.heart_beat_max_duty = light_command.heart_beat_max_duty;
				led.heart_beat_min_duty = light_command.heart_beat_min_duty;
				led.new_pulse_data = true;
				break;
			case CAN_COMMAND_ANGLE_FILTER_BANK:
				struct CANSurfaceCommand surface_command;
				can_unpack_surface_command(command_buffer, &surface_command);

				surface_update_command(surface_command);
				break;
			default:
				break;
			}
		}

		led.error_light_on = config.configuration_needed != 0; // Illuminate error if lacking configuration
		// TODO: Add error lighting if the servo is failing to hit the commands?
		operate_led(&led);
    /* USER CODE END WHILE */

    /* USER CODE BEGIN 3 */
	}
  /* USER CODE END 3 */
}

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
/* USER CODE BEGIN 4 */
/**
  * @brief  Retargets the C library printf function to the USART.
  * @param  None
  * @retval None
  */
PUTCHAR_PROTOTYPE
{
  /* Place your implementation of fputc here */
  /* e.g. write a character to the USART1 and Loop until the end of transmission */
  HAL_UART_Transmit(&huart1, (uint8_t *)&ch, 1, 0xFFFF);

  return ch;
}
/* USER CODE END 4 */

/**
  * @brief  Period elapsed callback in non blocking mode
  * @note   This function is called  when TIM1 interrupt took place, inside
  * HAL_TIM_IRQHandler(). It makes a direct call to HAL_IncTick() to increment
  * a global variable "uwTick" used as application time base.
  * @param  htim : TIM handle
  * @retval None
  */
void HAL_TIM_PeriodElapsedCallback(TIM_HandleTypeDef *htim)
{
  if (htim->Instance == TIM1)
  {
    HAL_IncTick();
  }
}

/**
  * @brief  This function is executed in case of error occurrence.
  * @retval None
  */
void Error_Handler(void)
{
  /* USER CODE BEGIN Error_Handler_Debug */
  /* User can add his own implementation to report the HAL error return state */
  __disable_irq();
  while (1)
  {
  }
  /* USER CODE END Error_Handler_Debug */
}
#ifdef USE_FULL_ASSERT
/**
  * @brief  Reports the name of the source file and the source line number
  *         where the assert_param error has occurred.
  * @param  file: pointer to the source file name
  * @param  line: assert_param error line source number
  * @retval None
  */
void assert_failed(uint8_t *file, uint32_t line)
{
  /* USER CODE BEGIN 6 */
  /* User can add his own implementation to report the file name and line number,
     ex: printf("Wrong parameters value: file %s on line %d\r\n", file, line) */
  /* USER CODE END 6 */
}
#endif /* USE_FULL_ASSERT */
