hpvdt/falcon_wing_module/firmware/wing_module/wing_module.ioc

Mcu.UserName=STM32F103T8Ux
PA0-WKUP.GPIO_Label=LED_RED
PA0-WKUP.Signal=S_TIM2_CH1_ETR
PA1.GPIO_Label=LED_WHITE
PA1.Signal=S_TIM2_CH2
PA10.Signal=USART1_RX
PA11.Signal=CAN_RX
PA12.Signal=CAN_TX
PA13.Signal=SYS_JTMS-SWDIO
PA14.Signal=SYS_JTCK-SWCLK
PA15.GPIO_Label=ADDR_0
PA15.Signal=GPIO_Input
PA2.GPIO_Label=ADS_RESET
PA2.Signal=GPIO_Output
PA3.GPIO_Label=ADS_DATA_RDY
PA3.Signal=GPIO_Input
PA4.GPIO_Label=ADS_CS
PA4.Signal=GPIO_Output
PA5.Signal=SPI1_SCK
PA6.Signal=SPI1_MISO
PA7.Signal=SPI1_MOSI
PA8.GPIO_Label=ADC_CLK_IN
PA8.Signal=RCC_MCO
PA9.Signal=USART1_TX
PB0.GPIO_Label=ANG_POT
PB0.Signal=ADCx_IN8
PB1.GPIO_Label=ADDR_2
PB1.Signal=GPIO_Input
PB2.GPIO_Label=ADDR_1
PB2.Signal=GPIO_Input
PB3.GPIO_Label=ADDR_3
PB3.Signal=GPIO_Input
PB4.GPIO_Label=ADDR_4
PB4.Signal=GPIO_Input
PB5.GPIO_Label=SERVO_PWM
PB5.Signal=S_TIM3_CH2
PB6.Signal=I2C1_SCL
PB7.Signal=I2C1_SDA
