hpvdt/falcon_wing_module/firmware/wing_module/Core/Inc/main.h

#define LED_RED_Pin GPIO_PIN_0
#define LED_RED_GPIO_Port GPIOA
#define LED_WHITE_Pin GPIO_PIN_1
#define LED_WHITE_GPIO_Port GPIOA
#define ADS_RESET_Pin GPIO_PIN_2
#define ADS_RESET_GPIO_Port GPIOA
#define ADS_DATA_RDY_Pin GPIO_PIN_3
#define ADS_DATA_RDY_GPIO_Port GPIOA
#define ADS_CS_Pin GPIO_PIN_4
#define ADS_CS_GPIO_Port GPIOA
#define ANG_POT_Pin GPIO_PIN_0
#define ANG_POT_GPIO_Port GPIOB
#define ADDR_2_Pin GPIO_PIN_1
#define ADDR_2_GPIO_Port GPIOB
#define ADDR_1_Pin GPIO_PIN_2
#define ADDR_1_GPIO_Port GPIOB
#define ADC_CLK_IN_Pin GPIO_PIN_8
#define ADC_CLK_IN_GPIO_Port GPIOA
#define ADDR_0_Pin GPIO_PIN_15
#define ADDR_0_GPIO_Port GPIOA
#define ADDR_3_Pin GPIO_PIN_3
#define ADDR_3_GPIO_Port GPIOB
#define ADDR_4_Pin GPIO_PIN_4
#define ADDR_4_GPIO_Port GPIOB
#define SERVO_PWM_Pin GPIO_PIN_5
#define SERVO_PWM_GPIO_Port GPIOB
#define LED_RED_CHANNEL TIM_CHANNEL_1
#define LED_WHITE_CHANNEL TIM_CHANNEL_2
#define SERVO_CHANNEL TIM_CHANNEL_2
