hpvdt/falcon_wing_module/(commit log)

2025-08-09 Uploaded original hardware designs
    [servo_regulator.kicad_pcb, servo_regulator.kicad_sch, spar_sensor.kicad_pcb, spar_sensor.kicad_sch]
2025-08-09 Added firmware for previous spar sensor
2025-08-14 Completed schematic for rev 1
    [wing_module_rev_1.kicad_pcb, wing_module_rev_1.kicad_sch]
2025-08-14 Split up schematic into multple pages, added CS pullup for ADC
    [can.kicad_sch, power.kicad_sch, strain.kicad_sch, wing_module_rev_1.kicad_pcb, wing_module_rev_1.kicad_sch]
2025-08-15 FIxed missing ADC heirarchical labels
    [strain.kicad_sch]
2025-08-16 Adjusted CAN connector order, drafting floorplan
    [can.kicad_sch, wing_module_rev_1.kicad_pcb]
2025-08-17 Finished rev 1.0 layout of CAN
    [strain.kicad_sch, wing_module_rev_1.kicad_pcb, wing_module_rev_1.kicad_sch]
2025-08-17 Reassigned reference numbers
    [can.kicad_sch, power.kicad_sch, strain.kicad_sch, wing_module_rev_1.kicad_pcb, wing_module_rev_1.kicad_sch]
2025-08-17 Added JLC tracking marker
    [wing_module_rev_1.kicad_pcb]
2025-08-18 added indicator board files
    [indicator.kicad_pcb, indicator.kicad_sch]
2025-08-18 Moved project for indicator board and updated the library symbols
    [indicator.kicad_pcb, indicator.kicad_sch, indicator_rev_2.kicad_pcb, indicator_rev_2.kicad_sch]
2025-08-30 Initial draft of basic ADS131M03 driver
2025-08-30 Fixed broadcast base IDs
    [can_wrapper.h]
2025-08-31 LED control drafted
2025-08-31 Start PWM outputs on boot
2025-08-31 Fixed LED control logic for pulses
    [led_control.c]
2025-08-31 Added `printf()` to UART code
2025-08-31 Updated ADC config and added calibration
2025-09-01 Added diagrams of wing atuation mechanism
2025-09-02 Added script for calculating wing sweep
2025-09-03 Fixed LED variable sizing and constants
    [led_control.c, led_control.h, main.c, main.h]
2025-09-03 Updated default PWM parameters
2025-09-03 Fixed integer division so result is signed
    [ads131m03.c]
2025-09-03 Fixed `printf()` string terminations to \r\n
    [main.c]
2025-09-03 Changed ADC reading to be signed for proper operation
2025-09-04 Made servo contol loop polled
2025-09-04 Adjusted servo PWM parameters to 50 Hz
2025-09-04 Disabled I2C due to conflict with servo PWM
    [wing_module_rev_1.kicad_sch]
2025-09-12 fixed mounting holes and connector
    [TCA6408ARSVR.step, TLV70033DCKR.step, indicator.kicad_pcb, indicator.kicad_sch]
2025-09-12 Update and rename indicator.kicad_pcb to indicator_rev_2.kicad_pcb
    [indicator_rev_2.kicad_pcb]
2025-09-12 updated mounting holes and connector
    [indicator_rev_2.kicad_pcb, indicator_rev_2.kicad_sch]
2025-09-12 modified i2c header and pushed connector
    [indicator_rev_2.kicad_pcb, indicator_rev_2.kicad_sch]
2025-09-12 added b. silkscreen text & modified board colours
    [indicator_rev_2.kicad_pcb]
2025-09-16 Added CAN start/stops when changing filters
2025-09-16 Fixed some bit-fielded enums to structs
    [can_wrapper.h]
2025-09-16 Fixed CAN data marshalling and buffer prep
    [can_wrapper.c]
2025-09-16 Fixed CAN filter updating to be done whenever needed
    [main.c]
2025-09-16 Removed servo testing code
2025-10-08 added production files
    [indicator_rev_2.kicad_pcb_bom.csv, indicator_rev_2.kicad_pcb_positions.csv]
2025-10-26 Fixed ANGLE command filter assignment
    [main.c, wing_module_config.c]
