hpvdt/falcon_wing_module/(notices)

Notices in the files:
firmware/wing_module/Core/Inc/main.h:
Copyright (c) 2025 STMicroelectronics.
All rights reserved.
This software is licensed under terms that can be found in the LICENSE file
